hsa-ees/piconut/sw/apps/ai/cone_detection/cone_detection_data/amz_00005.jpg

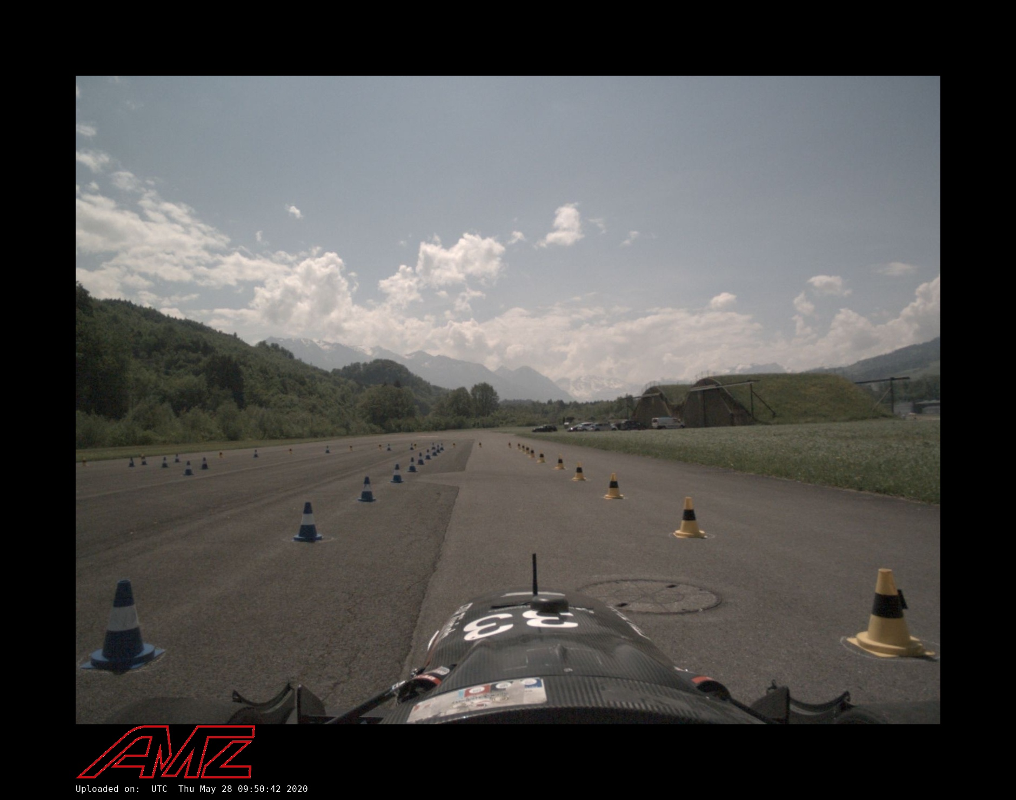
sw/apps/ai/cone_detection/cone_detection_data/amz_00005.jpg
