hsa-ees/piconut/sw/apps/ai/cone_detection/cone_detection_data/amz_01249.png

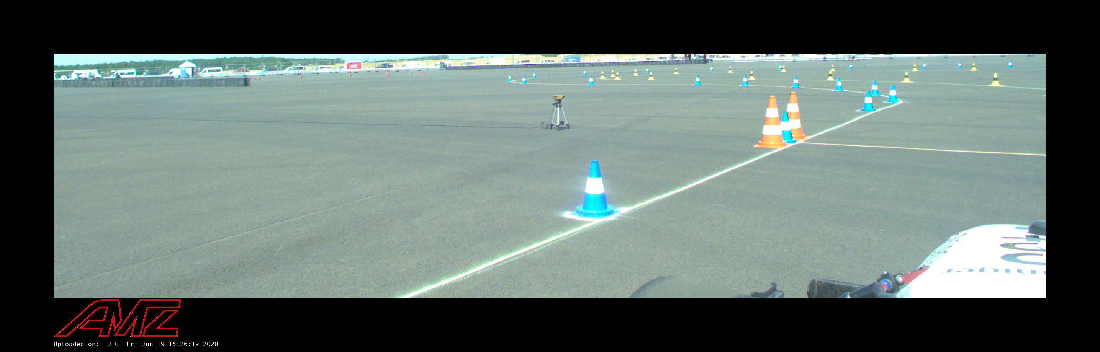
sw/apps/ai/cone_detection/cone_detection_data/amz_01249.png
