hsa-ees/piconut/sw/apps/ai/cone_detection/cone_detection_data/amz_03831.png

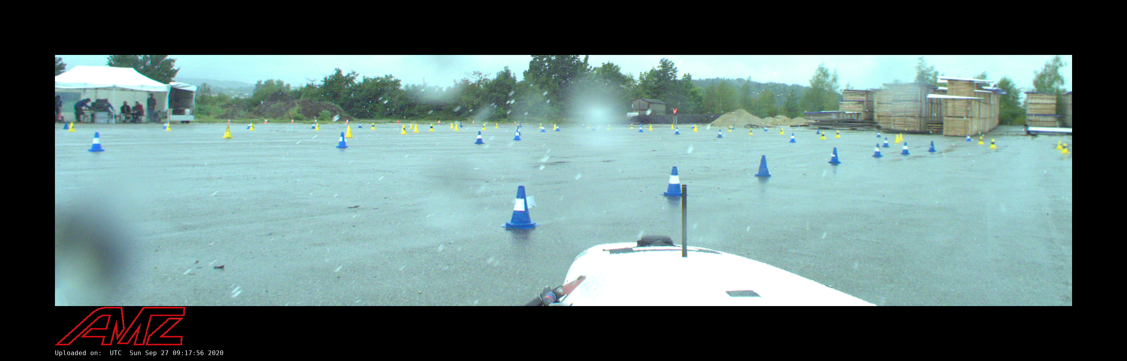
sw/apps/ai/cone_detection/cone_detection_data/amz_03831.png
