hsa-ees/piconut/doc/manual/piconut/peripherals.md

# Peripherals

```{toctree}
:maxdepth: 2

peripherals/uart.md
peripherals/video.md
peripherals/audio.md
peripherals/clint.md
peripherals/timer.md
peripherals/gui.md
peripherals/i2c.md
peripherals/gpio.md
peripherals/sdram_controller.md
```
