hsa-ees/piconut/doc/manual/piconut/software.md

# Software

The PicoNut project not only provides hardware design but also offers good
software support to help users get started quickly.

This includes software libraries geared towards PicoNut systems and RISC-V
and demonstrator applications showcasing the capabilities of PicoNut systems.

```{toctree}
:maxdepth: 2

software/demonstrators.md
software/libraries.md
```
