hsa-ees/piconut/doc/manual/piconut/interface_def.md

# Interface Definitions

```{toctree}
:maxdepth: 2

interface_def/ipdp.md
interface_def/csr_bus.md
interface_def/wishbone_bus.md
interface_def/software-sim_hardware.md
```
