hsa-ees/piconut/doc/manual/piconut/membrana.md

# Membrana Variants

```{toctree}
:maxdepth: 2

membrana/membrana_soft.md
membrana/membrana_hw.md
membrana/membrana_ref.md
```
