hsa-ees/piconut/doc/manual/piconut/nuclei.md

# Nucleus Variants

```{toctree}
:maxdepth: 2

nuclei/nucleus_ref.md
```
