hsa-ees/piconut/doc/manual/appendix/appendix.md

# Appendix

```{toctree}
:maxdepth: 2

toolchain.md
udev.md
```
