hsa-ees/piconut/doc/manual/piconut/software_library.md

# Software Support Library
**Under Construction**

```{toctree}
:maxdepth: 2

```
