hsa-ees/piconut/doc/manual/piconut/nuclei/nucleus_ref.md

# The Reference Nucleus
**Authors: Lorenz Sommer 2024, Johannes Hofmann 2025, Niklas Sirch 2025, Tristan Kundrat 2026**

```{contents} nucleus submodules
    :local:
    :depth: 2
```

This chapter gives an overview of the reference nucleus' capabilities and details its submodules.

## Overview

The main purpose of the reference nucleus is to provide a well documented and minimal implementation
of the [RV32 RISC-V ISA](https://drive.google.com/file/d/1uviu1nH-tScFfgrovvFCrj7Omv8tFtkp/view).

It is minimal in the sense that it does not contain any pipelines and does not support multi-nucleus architectures.

### Capabilities
The reference nucleus largely supports running of programs compiled by the RISC-V GCC toolchain. 
The nucleus is capable of running programs that utilize external peripherals and interrupt-driven
programming models.

It implements the following extensions of the RISC-V ISA:

- I (Base integer instruction set)
- A (Atomic instructions)
- M (Multiplication, division and remainder instructions)
- Zicsr (Control and Status Register instructions)
- Zifencei (Instruction-fetch fence instructions) - only implemented as a NOP operation as the
  reference nucleus is single core and does not reorder memory operations.

### Memory
The reference nucleus is intended for use with byte-addressable memory.
It interfaces with a so called "membrana" to access memory. It does not  access memory directly by itself.
Communication with the membrana is split into two ports, the instruction port for instruction fetching, and the data
port for `load` and `store` operations. For these ports, a [custom communication protocol](sec:idef:wishbone) has been created.
The membrana is connected to the internal system bus and acts as an interface for the nucleus' requests to the system bus.

### RISC-V Interrupt Support
The reference nucleus implements machine mode interrupt handling. The system supports the three standard machine mode interrupt types:

- **Machine External Interrupt (MEIP)** - Highest priority interrupt from external peripheral devices
- **Machine Timer Interrupt (MTIP)** - Medium priority interrupt for time-based scheduling and periodic tasks  
- **Machine Software Interrupt (MSIP)** - Lowest priority interrupt for inter-processor communication

The interrupt system includes a complete CSR (Control and Status Register) implementation with all required
machine mode registers: MIP, MIE, MSTATUS, MTVEC, MEPC, MCAUSE, and MTVAL. A hardware trap handling state machine
manages interrupt entry and exit sequences.

The nucleus integrates with CLINT (Core Local Interruptor) modules that provide memory-mapped timer and software
interrupt control at standard RISC-V addresses (base address 0x2000000).

Interrupt handling adds additional states to the controller's finite state machine, including trap entry sequences
for context saving and the MRET instruction for interrupt return. When an interrupt occurs, the hardware automatically
saves the current PC to MEPC, updates MCAUSE with the interrupt type, disables global interrupts, and transfers
control to the trap handler specified in MTVEC.

### Working principle
The reference nucleus utilizes a simple fetch-decode-execute workflow.
The `decode` step is always executed within one clock cycle. All instructions that are not `load` or `store`
instructions, also execute within one clock cycle. The `fetch` step is a IPort memory transaction and takes
3 clock cycles to complete. `load` operations require 4 clock cycles, store operations require 3.
For the time being, the ECALL and EBREAK operations halt the processor.
The FENCE operation is implemented as a NOP operation, as the nucleus does not reorder memory operations.
All Module outputs are always buffered in registers, limiting combinational logic depth and ensuring clean timing.

```{figure} figures/nucleus_ref/nucleus.drawio.svg
:align: center
reference nucleus block diagram
```

(sec:nucleus:alu)=
## Arithmetic Logic Unit (ALU)

```{figure} figures/nucleus_ref/alu.drawio.svg
:align: center
ALU module symbol
```

```{doxygenfunction} SC_MODULE(m_alu)
:project: nucleus_ref
```

### R&I-Type instructions

The ALU can handle R- and I-Type instructions. In order to correctly implement the few differences the two instruction
types have, a few distinctions have to be made. This concerns the fact, that there is no I-Type `subi` instruction.
As seen in the operation table, `funct7` decides whether subtraction is performed instead of
addition and whether to shift logically or arithmetically. According to the RISC-V
specification the only relevant values of the `funct7` block are `0x0` and `0x20` for the base RV32I instruction set
and `0x01` for the M extension. Additionally, even though I-Type instructions get decoded into their internal immediate value,
the position of the `funct7` block remains the same.

### Address calculation

Next to R- and I-Type instructions, the ALU is also indirectly used to perform address calculations for the load, store,
branch and jump instructions. It also performs the additions necessary for the LUI and AUIPC instructions. All of
the previously named instructions use the `force_add` flag to force the ALU to perform addition. Depending on the
instruction, the operands are selected accordingly by the control unit (controller). Possible sources for operand A
are `rs1` and `pc_out` (current program counter). Possible operands for operand B are `rs2` and `imm_out` (immediate value).

### Atomic Memory Operations (AMOs)

The ALU is also used to perform atomic memory operations (AMOs) from the RISC-V A-Extension.
When the controller sets the `force_amo` flag, the ALU will select the operation from
the `funct5` (contained inside `funct7`) block of the current instruction.

The 4 A-Extension specific operations `swap`, `min`, `minu`, `max` and `maxu` are implemented in
the ALU as well.

### M-/Zmmul-Extension
The M-Extension (multiplication, division and remainder instructions) are
handled by two modules: one for multiplication and one for division/remainder.

#### Multiplication and division module
Currently, multiplication is implemented as a simple shift-and-add multiplier
and division using a shift-and-subtract divider.
Calculation modules for the M-Extension can be found under `alu/m_extension/mul`
and `alu/m_extension/div` under the `nucleus_ref` folder.

Every division and multiplication module has the following structure:
```{figure} figures/nucleus_ref/mul-div-module.drawio.svg
:align: center
Multiplication/Division Module Block Diagram
```

Also, reset and clock signals are connected, if the calculation is not purely
combinatorial.

The signals have the following meaning:
| Signal name | Explanation |
| --- | --- |
| a_in | Value for calculation |
| b_in | Value for calculation |
| funct3_in | Funct3 from instruction. Contains which calculation should be made<br>(`mul`, `mulh`, `mulhu`, `mulhsu`, `div`, `divu`, `rem`, `remu`). |
| start_in | Must be set to High, when the inputs a_in and b_in are valid numbers and calculation should start.<br>Keep in mind to cache a_in and b_in in this cycle inside the multiplication/division module,<br>where start_in goes high, as after that cycle the program counter gets<br>incremented, thus the inputs can change. |
| y_out | Multiplication: {math}`a_{in} * b_{in} = y_{out}`<br>Division: {math}`a_{in} / b_{in} = y_{out}` or {math}`a_{in}\mod b_{in} = y_{out}` |
| valid_out | High, when calculation is done and the y_out signal is valid. |

##### Edge cases (for division)
Division should always round towards zero.
The following edge cases should be handled like so:
| Condition | Dividend (a) | Divisor (b) | `divu` | `remu` | `div` | `rem` |
| --- | --- | --- | --- | --- | --- | --- |
| Division by zero | {math}`x` | {math}`0` |{math}`2^{32} - 1` | {math}`x` | {math}`-1` | {math}`x` |
| Overflow (signed only) | {math}`-2^{31}` | {math}`-1` | - | - | {math}`-2^{31}` | {math}`0` |

##### Changing out the calculation modules
Signals to the multiplication and division module are connected in the `alu.cpp`
file. To change out the multiplication and/or division module with a different
version, multiple steps have to be taken. In this example, the new multiplication
module is called `mult_new` and the new division module `divi_new`.

First change the sources in the `nucleus_ref/Makefile`:
```make
# ...

# Module sources that are used for simulation and for synthesis ...
# Change the sources for the multiplication and division modules here.
MODULE_SRC := $(MODULE).cpp \
			  alu/alu.cpp \
			  alu/m_extension/mul/mult_new.cpp \
			  alu/m_extension/div/divi_new.cpp \

# ...

TESTBENCH_ALU_SRC := alu/alu.cpp \
					 alu/m_extension/mul/mult_new.cpp \
					 alu/m_extension/div/divi_new.cpp \
					 alu/alu_tb/alu_tb.cpp

# ...
```

Next, the submodules in the `nucleus_ref/alu/alu.h` header file:
```c
// ...

    /* Submodules */
#if PN_CFG_ALU_ENABLE_ZMMUL_EXTENSION == 1
    // Change class here, if you want to use a different multiplication module.
    // Also change imports accordingly.
    class m_mult_new* multiplication_module;
#endif
#if PN_CFG_ALU_ENABLE_M_EXTENSION == 1
    // Change class here, if you want to use a different division module.
    // Also change imports accordingly.
    class m_divi_new* division_module;
#endif

// ...
```

And finally, the imports and definitions in the `nucleus_ref/alu/alu.cpp` file:
```c
// ...

// change the following import to change out the multiplication module
#include "m_extension/mul/mult_new.h"
// change the following import to change out the division module
#include "m_extension/div/divi_new.h"

// ...

void m_alu::init_submodules()
{
#if PN_CFG_ALU_ENABLE_ZMMUL_EXTENSION == 1
    // change this assign according to the manual, if you want to replace
    // the multiplication module.
    multiplication_module = sc_new<m_mult_new>("mult_new");
    // ...
#endif
#if PN_CFG_ALU_ENABLE_M_EXTENSION == 1
    // change this assign according to the manual, if you want to replace
    // the division module.
    division_module = sc_new<m_divi_new>("divi_new");
    // ...
#endif
}
```

#### Enabling and disabling the M-/Zmmul-Extension
Enabling and disabling the M-/Zmmul-Extension is possible.

For enabling the entire M-Extension the variable `PN_MARCH` in the `piconut-config.mk`
has to be updated to `rv32im_zicsr` in the system using this nucleus.

Also the `PN_CFG_ALU_ENABLE_M_EXTENSION` variable in the same file has to be changed.
As an example, look at the file `piconut/systems/refdesign/piconut-config.mk`:
```make
## RISC-V ISA and extensions ...
## Changed -march argument for gcc. Comment following lines, if M and Zmmul
## extensions are not used.
# Uncomment following line, if only using Zmmul extension
# PN_MARCH ?= rv32i_zicsr_zmmul
# Uncomment following line, if using M extension
PN_MARCH ?= rv32im_zicsr

# ...

# M-Extension ...
#   Enable (1) or Disable (0) M-Extension
PN_CFG_ALU_ENABLE_M_EXTENSION ?= 1
#   Enable (1) or Disable (0) Zmmul-Extension
PN_CFG_ALU_ENABLE_ZMMUL_EXTENSION ?= 1
```

Enabling only the Zmmul-Extension, we need the following in the systems `piconut-config.mk`:
```make
## RISC-V ISA and extensions ...
## Changed -march argument for gcc. Comment following lines, if M and Zmmul
## extensions are not used.
# Uncomment following line, if only using Zmmul extension
PN_MARCH ?= rv32i_zicsr_zmmul
# Uncomment following line, if using M extension
# PN_MARCH ?= rv32im_zicsr

# ...

# M-Extension ...
#   Enable (1) or Disable (0) M-Extension
PN_CFG_ALU_ENABLE_M_EXTENSION ?= 0
#   Enable (1) or Disable (0) Zmmul-Extension
PN_CFG_ALU_ENABLE_ZMMUL_EXTENSION ?= 1
```

Disabling everything is possible via commenting the line in `piconut-config.mk` of the system
and setting both config enables to zero:
```make
## RISC-V ISA and extensions ...
## Changed -march argument for gcc. Comment following lines, if M and Zmmul
## extensions are not used.
# Uncomment following line, if only using Zmmul extension
# PN_MARCH ?= rv32i_zicsr_zmmul
# Uncomment following line, if using M extension
# PN_MARCH ?= rv32im_zicsr

# ...

# M-Extension ...
#   Enable (1) or Disable (0) M-Extension
PN_CFG_ALU_ENABLE_M_EXTENSION ?= 0
#   Enable (1) or Disable (0) Zmmul-Extension
PN_CFG_ALU_ENABLE_ZMMUL_EXTENSION ?= 0
```
Keep in mind, that the `PN_CFG_...` variables may be set by the `piconut-config.mk` in the root
directory of this project, so comment those lines out or change them accordingly.

(sec:nucleus:fpu)=
## Floating-Point Unit (FPU) &ndash; F-Extension

The reference nucleus includes a Floating-Point Unit that implements hardware-support for Floating-Point Numbers.

The module currently supports the following extensions:

- F (Single-Precision)

This module sits inside the nucleus and works alongside the ALU.

```{figure} figures/nucleus_ref/fpu.drawio.svg
:align: center
fpu / f-extension block diagram
```

```{doxygenfunction} SC_MODULE(m_f_extension)
:project: f_extension
```

### Regfile (Float)
```{doxygenfunction} SC_MODULE(m_regfile_float)
:project: f_extension
```

### Adder (Float)
```{doxygenfunction} SC_MODULE(m_adder_float)
:project: f_extension
```

### Multiplier (Float)
```{doxygenfunction} SC_MODULE(m_multiplier_float)
:project: f_extension
```

### Divisor (Float)
```{doxygenfunction} SC_MODULE(m_divisor_float)
:project: f_extension
```

### Square Root (Float)
```{doxygenfunction} SC_MODULE(m_sqrt_float)
:project: f_extension
```

### Fused Multiply-Adder (Float)
```{doxygenfunction} SC_MODULE(m_mul_add_float)
:project: f_extension
```

### Classifier (Float)
```{doxygenfunction} SC_MODULE(m_classifier_float)
:project: f_extension
```

### Comparer (Float)
```{doxygenfunction} SC_MODULE(m_compare_float)
:project: f_extension
```

### Converter (Float)
```{doxygenfunction} SC_MODULE(m_converter_float)
:project: f_extension
```

#### Enabling and disabling the F-Extension
Enabling and disabling the F-Extension is possible.

For enabling the entire F-Extension the variable `PN_MARCH` in the `piconut-config.mk`
has to be updated to `rv32if_zicsr` in the system using this nucleus.

Also the `PN_CFG_ENABLE_F_EXTENSION` variable in the same file has to be changed.
As an example, look at the file `piconut/systems/refdesign/piconut-config.mk`:
```make
## RISC-V ISA and extensions ...
# Uncomment following line, if using F extension:
# export PN_MARCH := rv32imf_zicsr

# ...

#   Enable (1) or Disable (0) F-Extension
#   Remember to also set:
#   export PN_MARCH := rv32imf_zicsr
#   for the compiler to actually use the extension
PN_CFG_ENABLE_F_EXTENSION ?= 0
```

Keep in mind, that the `PN_CFG_...` variables may be set by the `piconut-config.mk` in the root
directory of this project, so comment those lines out or change them accordingly.

(sec:nucleus:scalar_crypto)=
## Scalar Cryptography

The reference nucleus includes a scalar cryptography module that implements parts of the
[RISC-V Scalar Cryptography Extension](https://docs.riscv.org/reference/isa/unpriv/scalar-crypto.html).

The module currently supports the following extensions:

- Zkne for RV32 (NIST Encryption = AES)
- Zknd for RV32 (NIST Decryption = AES)

This module is integrated into the ALU and started when a crypto instruction is executed. Like
multiplication this module operates over multiple cycles. 

```{doxygenfunction} SC_MODULE(m_scalar_crypto)
:project: nucleus_ref
```

### AES Instructions (Zkne, Zknd)

#### Algorithm 

The Advanced Encryption Standard (AES) is the Standard for symmetric encryption specified by the
National Institute of Standards and Technology (NIST). 

AES is a round-based cipher. The number of rounds depends on the key size, and the algorithm
includes a special final round. These operations implement the core principles of symmetric-key
cryptography: confusion (making the output significantly different from the input) and diffusion
(spreading input bits across the output), combined with the addition of the round key. Decryption
applies the inverse operations in reverse order.
The basic operations displayed in the [figure below](#fig:aes_overview) of AES encryption are:

- SubBytes
  Substitution of bytes via a lookup table (S-box)
- ShiftRows
  Shifting of rows in the state matrix
- MixColumns
  Mixing of columns in the state matrix via matrix multiplication
- AddRoundKey
  XORing the state matrix with a round key

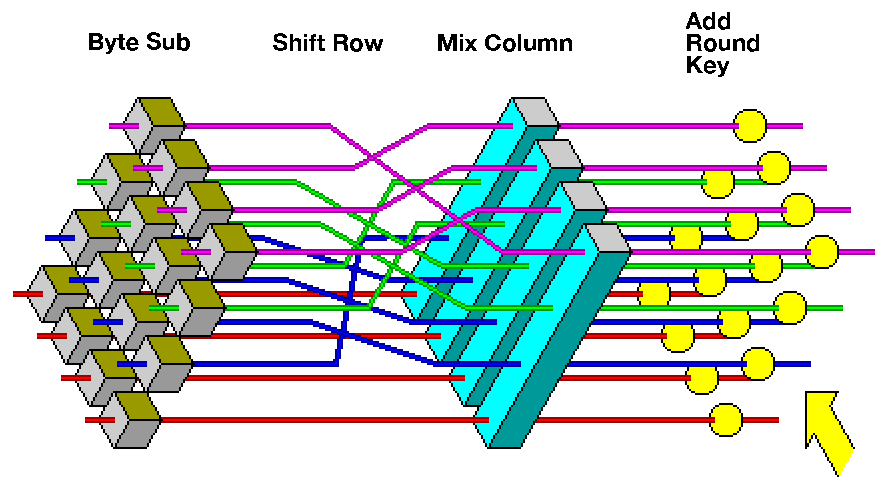
[picture p53: doc/manual/piconut/nuclei/figures/nucleus_ref/aes.png]
```{figure} figures/nucleus_ref/aes.png
:scale: 40
:align: center
:name: fig:aes_overview

AES algorithm overview (original by John Savard, CC0)
```

For the exact math please refer to
[FIPS 197](https://nvlpubs.nist.gov/nistpubs/FIPS/NIST.FIPS.197.pdf) or
[Wikipedia](https://en.wikipedia.org/wiki/Advanced_Encryption_Standard).

#### Instructions

The Zkne and Zknd extensions implement AES encryption and decryption instructions, respectively.
They are split because some cryptographic modes do not require decryption support.

There are four instructions implemented for AES encryption and decryption:

- `aes32esmi` – Middle-round AES encryption
- `aes32dsmi` – Middle-round AES decryption
- `aes32esi` – Final-round AES encryption
- `aes32dsi` – Final-round AES decryption

The instructions can be used to construct AES in software and also assist with key schedule generation.
More details can be found in the [Software Chapter](sec:sw:crypto).

The implementation of Zkne and Zknd in the reference nucleus is simple but performant for 40MHz
clock speed.

Better implementations focus on side-channel resistance, less footprint and support for faster clock
speeds but for the purpose of this reference nucleus, this implementation is sufficient.

For the exact implementation please refer to the commented source code.

(sec:nucleus:regfile)=
## Regfile

The regfile component of the nucleus is used to store temporary values that are needed for calculations
and program flow. It contains 32 32-bit registers.

```{list-table} Regfile input ports
:name: "nucleus:tab:regfile_input_ports"
:header-rows: 1

*   - Port name
    - Signal width
    - Description
*   - data_in
    - 32
    - Data input
*   - select_in
    - 5
    - Selects the register in which input data is stored
*   - rs1_select_in
    - 5
    - Selects which registers value gets output to output port `rs1_out`
*   - rs2_select_in
    - 5
    - Selects which registers value gets output to output port `rs2_out`
*   - en_load_in
    - 1
    - Control signal to enable/disable storing of input data with the next rising edge.
```

```{list-table} Regfile output ports
:name: "nucleus:tab:regfile_output_ports"
:header-rows: 1

*   - Port name
    - Signal width
    - Description
*   - rs1_out
    - 32
    - Output of the register selected by `rs1_select_in`
*   - rs2_out
    - 32
    - Output of the register selected by `rs2_select_in`
```

```{figure} figures/nucleus_ref/regfile.drawio.svg
:align: center
Regfile module symbol
```

The register `x0` holds the permanent value `0x00000000` according to the RISC-V specification.
The reset value of all registers is `0x00000000`.

(sec:nucleus:pc)=
## Program Counter (PC)

The program counter module is used to store the address of the current instruction at any given time. Its content
can be thought of as the current position within the program. The program counter is incremented by `0x4` with the next
rising edge, once the controller sets the `s_pc_inc4` control signal. Its internal value can be overwritten with the value
at its input port with the next rising edge if `s_pc_ld_en` is set. This is used to perform jump and branch instructions.

### PC Interrupt
The PC module supports RISC-V interrupt and exception handling by providing mechanisms to:
- Load trap handler addresses from the MTVEC CSR during interrupt/exception entryg
- Restore return addresses from the MEPC CSR during MRET instruction execution  

### PC Control Priority

The PC module implements a priority-based loading mechanism where interrupt/exception handling takes precedence over 
normal program flow control. The priority order (highest to lowest) is:

1. **Debug level exit** - Loads address from DPC CSR
2. **Debug level entry** - Loads debug handler start address
3. **Trap handler entry** - Loads trap handler address from MTVEC CSR
4. **Interrupt return (MRET)** - Loads return address from MEPC CSR
5. **Normal load** - Loads address from `pc_in` (jump/branch instructions)
6. **Increment** - Increments PC by 4 (normal instruction sequence)

```{list-table} Program counter input ports
:name: "nucleus:tab:pc_input_ports"
:header-rows: 1

*   - Port name
    - Signal width
    - Description
*   - pc_in
    - 32
    - Data input for when the PC is to be manipulated by jump and branch instructions.
*   - inc_in
    - 1
    - Control signal. When set, the PC is incremented by `0x4` at the next rising edge.
*   - en_load_in
    - 1
    - Control signal. Enables loading of a new value with the next rising edge.
*   - debug_level_enter_in
    - 1
    - Debug level entry signal. Loads debug handler start address.
*   - debug_level_leave_in
    - 1
    - Debug level exit signal. Loads address from DPC CSR.
*   - csr_dpc_in
    - 32
    - Debug Program Counter from CSR module.
*   - trap_handler_enter_in
    - 1
    - Trap handler entry signal for interrupt/exception handling.
*   - csr_mtvec_in
    - 32
    - Machine Trap Vector from CSR module containing trap handler base address.
*   - mret_in
    - 1
    - Machine Return instruction signal for interrupt/exception return.
*   - csr_mepc_in
    - 32
    - Machine Exception Program Counter from CSR module containing return address.
```

```{note} Program counter internal register
The internal register of the program counter is **30 bits wide**. The lowest two bits of any given address pertaining
to the main program in memory can be omitted because every instruction is naturally word aligned and 4 bytes in size.
To maintain a level of consistency for the program counters interactions with other modules and the instruction port
interface, the output and input ports kept at a width of 32 bits. The lowest two bits are simply set to a constant `0` at the output and dismissed at the input. Instead of
every connected module having to append these two zeroes at their inputs, it is done once at the PCs output. The same goes for the PC input port.
```

### Interrupt and Exception Handling

The PC module plays a critical role in RISC-V interrupt and exception handling:

**Trap Entry**: When an interrupt or exception occurs, the controller asserts `trap_handler_enter_in`, causing the PC 
to load the trap handler address from the MTVEC CSR. This automatically transfers control to the interrupt service routine.

**Trap Exit**: The MRET (Machine Return) instruction asserts `mret_in`, causing the PC to load the return address 
from the MEPC CSR, restoring execution to the point where the interrupt occurred.

**Priority Handling**: The PC module ensures that interrupt/exception control takes precedence over normal program 
flow, preventing race conditions during trap handling sequences.

```{list-table} Program counter output ports
:name: "nucleus:tab:pc_output_ports"
:header-rows: 1

*   - Port name
    - Signal width
    - Description
*   - pc_out
    - 32
    - Constant output of the internal register.
```

```{figure} figures/nucleus_ref/pc.drawio.svg
:align: center
Program counter module symbol
```

(sec:nucleus:ir)=
## Instruction Register (IR)

The instruction register module stores the current instruction in its internal register and provides its content
to the rest of the nucleus via a constant output.

```{list-table} Instruction register input ports
:name: "nucleus:tab:ir_input_ports"
:header-rows: 1

*   - Port name
    - Signal width
    - Description
*   - ir_in
    - 32
    - Input data. Internal register takes on this value at the next rising edge.
*   - en_load_in
    - 1
    - Control signal. Enables loading of a new value with the next rising edge.
```

```{list-table} Instruction register output ports
:name: "nucleus:tab:ir_output_ports"
:header-rows: 1

*   - Port name
    - Signal width
    - Description
*   - ir_out
    - 32
    - Constant output of the internal register.
```

The IR input port `data_in` is connected to the IPort `rdata` signal.

```{figure} figures/nucleus_ref/ir.drawio.svg
:align: center
Instruction register module symbol
```

(sec:nucleus:immgen)=
## Immediate Generator (immgen)

The immediate generator (immgen) module decodes the current instruction and generates an immediate value from it.
All but the R-Type instruction type carry an immediate value. This immediate value is a simple constant built into
an instruction.

```{list-table} Immediate generator input ports
:name: "nucleus:tab:immgen_input_ports"
:header-rows: 1

*   - Port name
    - Signal width
    - Description
*   - data_in
    - 32
    - Instruction word from which an immediate value is to be generated from.
```

```{list-table} Immediate generator output ports
:name: "nucleus:tab:immgen_output_ports"
:header-rows: 1

*   - Port name
    - Signal width
    - Description
*   - imm_out
    - 32
    - Immediate value generated from an instruction word.
```

Immediate values are decoded differently and serve a different purpose depending on the instruction and instruction type.
Decoding and generation are executed in accordance with the [RISC-V specification](https://drive.google.com/file/d/1uviu1nH-tScFfgrovvFCrj7Omv8tFtkp/edit)
page 44, section "Immediate Encoding Variants.

```{list-table} Immediate encoding variants
:name: "nucleus:tab:immgen_decoding"
:header-rows: 1

*   - Instruction Type
    - Resulting immediate value
*   - I-Type
    - `(inst[31])[31:11] + inst[30:25] + inst[24:21] + inst[20]`
*   - S-Type
    - `(inst[31])[31:11] + inst[30:25] + inst[11:8]  + inst[7]`
*   - B-Type
    - `(inst[31])[31:12] + inst[7]     + inst[30:25] + inst[11:8]  + 0`
*   - U-Type
    - `inst[31]          + inst[30:20] + inst[19:12] + 0[11:0]`
*   - J-Type
    - `(inst[31])[31:20] + inst[19:12] + inst[20]    + inst[30:25] + inst[24:21] + 0`

```

```{admonition} How to read the immediate encoding table
:class: tip

In the table above, `inst` stands for the current instruction word from which an immediate value is to be generated from.
The operator `+` in this case stands for concatenation of bits/bit-ranges.
Additionally, syntax like `(inst[31])[31:12]` resolves as: "fill the range `[31:12]` in the output value with `inst[31]`".
```

The immediate generator module detects the correct decoding variant by evaluating the `opcode` field of the current
instruction. Groups of instructions in the RV32I subset (load/store/immediate/branch/jump/upper immediate) do not
always use the same instruction type format across the board.

```{list-table} Instructions by instruction type
:name: "nucleus:tab:instruction_type_per_instruction"
:header-rows: 1

*   - Instruction type
    - Instructions
*   - I-Type
    - All "immediate arithmetic" instructions, all `load` instructions, **`jalr`**
*   - S-Type
    - All `store` instructions
*   - B-Type
    - All `branch` instructions
*   - U-Type
    - `lui`, `auipc`
*   - J-Type
    - `jal`
```

```{note}
The R-Type instruction format is not listed, since it does not contain an immediate value.
```

```{figure} figures/nucleus_ref/immgen.drawio.svg
:align: center
Immediate generator module symbol
```

(sec:nucleus:byteselector)=
## Byteselector

The byteselector module generates the `bsel` signal. This signal is forwarded to the data port interface as
well as modules that handle memory access. It is necessary for the implementation of byte and halfword load/
store commands.

```{list-table} Byteselector input ports
:name: "nucleus:tab:bsel_input_ports"
:header-rows: 1

*   - Port name
    - Signal width
    - Description
*   - adr_in
    - 2
    - Lowest two bits of the `alu_out` signal which represents the alignment of a calculated address.
*   - funct3_in
    - 3
    - `funct3` block of the current instruction.
```

```{list-table} Byteselector output ports
:name: "nucleus:tab:bsel_output_ports"
:header-rows: 1

*   - Port name
    - Signal width
    - Description
*   - byteselect_out
    - 4
    - Outgoing byteselect signal.
*   - invalid_out
    - 1
    - Set if adress is misaligned.

```

Because memory accesses always use a full 32-bit word aligned address (lowest two bits are `0`) it is necessary to
generate an additional signal to allow for loading/storing of individual bytes and halfwords. This `bsel` signal
signifies which of the 4 bytes of a 32-bit word at a given address are to be loaded from or stored to. The `bsel` signal
is 4 bits wide and each bit represents a single byte of a 32-bit word.

When an address is calculated by the ALU, only the upper 30 bits are forwarded to the data port interface.
Memory accesses must always be word aligned and thus the lowest two bits of any address must always be `00`.
This is because the main memory is byte-addressable and therefore 32-bit words sit in memory in intervals of `0x4`,
leading to the lowest to bits always being `00`.For the purpose of generating the `bsel` signal, they - along with the
`funct3`  block of the current  instruction - lead to the following `bsel` signal assignments.

```{list-table} Byteselect generation table
:name: "nucleus:tab:bsel_generation_table"
:header-rows: 1

*   - adr_in
    - funct3_in
    - bsel_out
*   - `00`
    - lb/lbu/sb
    - `0001`
*   - `01`
    - lb/lbu/sb
    - `0010`
*   - `10`
    - lb/lbu/sb
    - `0100`
*   - `11`
    - lb/lbu/sb
    - `1000`
*   - `00`
    - lh/lhu/sh
    - `0011`
*   - `10`
    - lh/lhu/sh
    - `1100`
*   - `01`
    - lh/lhu/sh
    - invalid, `invalid_out` is set
*   - `11`
    - lh/lhu/sh
    - invalid, `invalid_out` is set
*   - `00`
    - lw
    - `1111`
*   - `01`
    - lw
    - invalid, `invalid_out` is set
*   - `10`
    - lw
    - invalid, `invalid_out` is set
*   - `11`
    - lw
    - invalid, `invalid_out` is set
```

```{note}
The nucleus currently only supports fully 32-bit aligned loads and stores. It is not possible to load/store data
beyond the 32-bit boundary of any address. Additionally, disjointed loads are also not supported. (for example `bsel` `0101`).
```
### Examples

To further illustrate the interaction between the effective address and the `bsel` signal, consider the following examples:

Assume the following memory layout.

| Address | Value |
| --- | --- |
| `0x00000000` | `0x12 0x34 0x56 0x78` |
| `0x00000004` | `0xCA 0xFE 0xBA 0xBE` |

#### Example 1

1. Let the registers `x1` and `x2` contain the value `0`.
2. Let the current instruction be `lb x1, 1(x2)`.
3. This reads as "load the value of the byte at address `0x00000000` offset by `0x1` into `x1`.
4. This leads to an effective target address of `0x00000001`.
5. The targeted byte is therefore `0x34`.
6. The address at the dport interface wil be `0x00000000`. (Lowest two bits always `00`!)
7. The byteselector will evaluate the `funct3` block (here: `0x0`) and the lowest two bits of the effective address
   (here: `0x1`), resulting in a `bsel` value of `0010`.
8. After the memory access transaction is complete, the register `x1` will contain the value `0x00000034`.

#### Example 2

1. Let the register `x1` contain the value `0x0` and register `x2` contain the value `0x00000004`.
2. Let the current instruction be `lh x1, 2(x2)`.
3. This reads as "load the value of the halfword at address `0x00000004` offset by `0x2` into `x1`.
4. This leads to an effective address of `0x00000006`.
5. The targeted halfword is therefore `0xBABE`.
6. The address at the dport interface wil be `0x00000004`. (Lowest two bits always `00`!)
7. The byteselector will evaluate the `funct3` block (here: `0x1`) and the lowest two bits of the effective address
   (here: `0x2`), resulting in a `bsel` value of `1100`.
8. After the memory transaction is complete. the register `x1` will contain the value `0x0000BABE`.

```{note}
The examples above only demonstrate the generation and function of the `bsel` signal. A full memory transaction involves
additional modules.
```

```{figure} figures/nucleus_ref/byteselector.drawio.svg
:align: center

Byteselector module symbol
```

(sec:nucleus:extender)=
## Extender

The extender module prepares **incoming** data requested by the nucleus via load instructions. It ensures
relevant data is in the correct position within the data word and sign extends it, if needed.

```{list-table} Extender input ports
:name: "nucleus:tab:extender_input_ports"
:header-rows: 1

*   - Port name
    - Signal width
    - Description
*   - data_in
    - 32
    - Incoming data word to be processed
*   - funct3_in
    - 3
    - funct3 block of the current instruction
*   - bsel_in
    - 4
    - Byteselect signal generated by the byteselector.
```

```{list-table} Extender output ports
:name: "nucleus:tab:extender_output_ports"
:header-rows: 1

*   - Port name
    - Signal width
    - Description
*   - extend_out
    - 32
    - Processed data word
```

When the nucleus requests data from memory via a load instruction, the membrana will always provide a 32-bit
data word. If the load instruction requests a full 32-bit word (lw instruction) no further steps have to be taken and
the full data word is stored in the target internal register. This changes, when the nucleus requests to load
a byte or halfword via the lb or lh instructions respectively. The membrana will still provide a 32-bit word
with the relevant data occupying either any of the single 4 bytes within the full word (lb) or two consecutive bytes
(lh). The purpose of this module is to resolve this arrangement and to reorient it to form a new 32-bit word
that represents this data. For this, the extender module uses the `bsel` signal already provided by the
[Byteselector](sec:nucleus:byteselector) buffered through the `bsel` register. The `bsel` signal represents a
mask where each of its bits corresponds to a byte in the incoming data word.

```{list-table} Extender output table
:name: "nucleus:tab:extender_table"
:header-rows: 1

*   - Incoming data
    - `bsel`
    - Output
*   - `0x12345678`
    - `0001`
    - `0x00000078`
*   - `0x12345678`
    - `0010`
    - `0x00000056`
*   - `0x12345678`
    - `0100`
    - `0x00000034`
*   - `0x12345678`
    - `1000`
    - `0x00000012`
*   - `0x12345678`
    - `0011`
    - `0x00005678`
*   - `0x12345678`
    - `1100`
    - `0x00001234`
```

In addition to rearranging the relevant bytes or halfwords, the extender module
is responsible for applying the correct extension to the loaded data. For `lb`
and `lh` instructions, sign extension is performed: the module inspects the most
significant bit of the selected byte or halfword and, if it is set, fills the
upper bits of the output word with ones. For `lbu` and `lhu` instructions, zero
extension is applied, ensuring the upper bits are cleared. This behavior is
determined by evaluating the `funct3` field of the current instruction.

For A-Extension instructions, write-backs from the `rdata` register require the extender module to
use the `bsel` value stored in the `bsel` register, which holds the `bsel` from the most recent load
instruction. This is necessary because, during A-Extension operations, the address is not calculated
by the ALU, so the current `bsel` would not reflect the correct byte selection. 

```{figure} figures/nucleus_ref/extender.drawio.svg
:align: center
Extender module symbol
```

(sec:nucleus:datahandler)=
## Datahandler

The datahandler module is prepares **outgoing** data to the Dport interface. It ensures data within the outgoing 32-bit
word is in the correct position.

```{list-table} Datahandler input ports
:name: "nucleus:tab:datahandler_input_ports"
:header-rows: 1

*   - Port name
    - Signal width
    - Description
*   - data_in
    - 32
    - Incoming data word to be processed
*   - bsel_in
    - 4
    - Byteselect signal generated by the byteselector
```

```{list-table} Datahandler output ports
:name: "nucleus:tab:datahandler_output_ports"
:header-rows: 1

*   - Port name
    - Signal width
    - Description
*   - data_out
    - 32
    - Processed data word
```

Data stored in any internal register (the regfile) occupies the low bits of the register according to the RISC-V
specification. However, since `sb` and `sh` instructions enable the storing of individual bytes and halfwords to a
specific, byte or halfword aligned position within any given memory address, it is necessary to rearrange outgoing
data accordingly. Essentially, the datahandler module performs the inverse operation of the
[extender module](sec:nucleus:extender). It uses the `bsel` signal to determine which position within the outgoing
data word the incoming data should occupy. Unlike the [extender module](sec:nucleus:extender), it does not perform
any sign or zero extension.

```{list-table} Datahandler output table
:name: "nucleus:tab:datahandler_table"
:header-rows: 1

*   - Incoming data
    - `bsel`
    - Output
*   - `0x00000012`
    - `1000`
    - `0x12000000`
*   - `0x00000012`
    - `0100`
    - `0x00120000`
*   - `0x00000012`
    - `0010`
    - `0x00001200`
*   - `0x00000012`
    - `0001`
    - `0x00000012`
*   - `0x00001234`
    - `1100`
    - `0x12340000`
*   - `0x00001234`
    - `0011`
    - `0x00001234`
*   - `0x12345678`
    - `1111`
    - `0x12345678`
```

```{figure} figures/nucleus_ref/datahandler.drawio.svg
:align: center
Datahandler module symbol
```

(sec:nucleus:controller)=
## Controller

The controller (also known as the control unit) is a finite state machine that sets a number of control signals which control
signal flow and toggle functions of other submodules. It reads status signals from various parts of the nucleus and evaluates
them at specific decision points to facilitate the overall function of executing instructions by setting control signals accordingly.
The controller also implements interrupt and trap handling, managing the multi-state sequences required for
interrupt entry, context saving, and interrupt return (MRET) operations.

```{doxygenfunction} SC_MODULE(m_controller)
:project: nucleus_ref
```
The controller operates as a finite state machine with 53 distinct internal states, transitioning
between them based on current status signals and instruction flow.

The diagram below provides an overview of the controller's state machine and its transitions.

```{figure} figures/nucleus_ref/controller.drawio.svg
:align: center
Controller state machine diagram
```

```{list-table} Controller logical states
:name: "nucleus:tab:controller_states"
:header-rows: 1

*   - State name
    - Description
*   - `RESET`
    - Initial state. Resets all control signals.
*   - `IPORT_STB`
    - Instruction port strobe is set high.
*   - `AWAIT_IPORT_ACK`
    - Await the instruction port acknowledge signal.
*   - `DECODE`
    - Instruction fetched. Decode the current instruction.
*   - `ALU1`
    - Execute ALU instructions, PC advances by `0x4`.
*   - `ALU2`
    - Execute ALU instructions, PC does not change.
*   - `ALU_IMM`
    - Execute immediate ALU operations (I-Type).
*   - `ALU_IMM_SHIFT`
    - Execute immediate ALU shift instructions.
*   - `LUI`
    - Execute upper immediate instructions.
*   - `AUIPC`
    - Execute add upper immediate to PC instructions.
*   - `NOP`
    - No operation, PC advances by `0x4`.
*   - `BRANCH`
    - Calculate branch target address and set PC if condition is met.
*  - `DONT_BRANCH`
    - Do not branch, PC advances by `0x4`.
*   - `JAL`
    - Jump and link instruction. Calculate address and set PC.
*   - `JALR`
    - Jump and link register instruction. Calculate address and set PC.
```

### Load and Store

The load and store procedures (and related states) are subject to optimization and currently focus on on eliminating
potential edge cases to ensure proper function.

```{list-table} Controller load/store states
:name: "nucleus:tab:controller_load_store_states"
:header-rows: 1

*   - State name
    - Description
*   - `LOAD1`
    - Await data port acknowledge signal is low to ensure no conflict with an ongoing transaction. Then go to `LOAD2` else remain.
*   - `LOAD2`
    - Set data port strobe signal high to begin transaction. Calculate the target address and increment PC. Go to `LOAD3`.
*   - `LOAD3`
    - Await data port acknowledge signal. If high, go to `LOAD4`, else remain.
*   - `LOAD4`
    - Data port acknowledge signal is high. Enable regfile to load data and go to `IPORT_STB`.
*   -
    -
*   - `STORE1`
    - Await data port acknowledge signal is low to ensure no conflict with an ongoing transaction. Then go to `STORE2` else remain.
*   - `STORE2`
    - Set data port strobe signal high to begin transaction. Calculate the target address and increment PC. Set write enable signal high. Go to `STORE3`.
*   - `STORE3`
    - Await data port acknowledge signal. If high, go to `IPORT_STB`, else remain.
```

The interrupt and trap handling procedures extend the controller with additional states for interrupt processing and CSR instruction execution.

```{list-table} Controller interrupt and trap states
:name: "nucleus:tab:controller_interrupt_states"
:header-rows: 1

*   - State name
    - Description
*   - `STATE_TRAP_ENTRY`
    - Initial trap detection. Save current PC to MEPC register.
*   - `STATE_TRAP_SAVE_MCAUSE`
    - Determine interrupt type by priority and save to MCAUSE register with interrupt flag set.
*   - `STATE_TRAP_UPDATE_MSTATUS`
    - Read current MSTATUS register to preserve state.
*   - `STATE_TRAP_UPDATE_MSTATUS2`
    - Save current MIE bit to MPIE field and clear MIE bit to disable global interrupts.
*   - `STATE_TRAP_LOAD_HANDLER`
    - Read trap handler base address from MTVEC register.
*   - `STATE_TRAP_SAVE_PC`
    - Transfer control to interrupt handler by loading trap handler address into PC.
*   - `STATE_MRET`
    - Execute machine return (MRET) instruction: restore MIE from MPIE, load PC from MEPC.
```
```{note}
The controller checks for a pending interrupt condition in several states: during the instruction_finished() routine as well as in the IPORT_STB and AWAIT_IPORT_ACK states. If an interrupt is pending in any of these, the state machine immediately transitions to STATE_TRAP_ENTRY to initiate the trap handling sequence.
```
```{note}
While load and store procedures are essentially the same, the load procedure required an additional state to
avoid erroneous behavior when the target and source register (that holds the target address) are the same.
The specific solution was to delay the  signals that allow the regfile to load a new value (`c_reg_ldmem`, `c_reg_ld_en`)
and enable them only after the bus transaction is complete and when the data present at the regfile input signal is valid.

There is potential for skipping over states when certain conditions are met, this however has not
 been explored with this implementation and is subject to future optimization.
```

### Branching

Because the `BRANCH` and `DONT_BRANCH` transition edges would clutter the diagram unnecessarily, their conditions
are detailed in the following table

```{note}
The table is meant to be read such that if the conditions in the "Conditions" column are met, the controller transitions
into the `BRANCH` state, else it transitions into the `DONT_BRANCH` state.
```

```{list-table} Branch conditions
:name: "nucleus:tab:branch_conditions"
:header-rows: 1

*   - Branch Type and opcode
    - Condition
*   - `BEQ`, `0x0`
    - `s_alu_equal == 1`
*   - `BNE`, `0x1`
    - `s_alu_equal == 0`
*   - `BLT`, `0x4`
    - `s_alu_less == 1`
*   - `BGE`, `0x5`
    - `s_alu_less == 0`
*   - `BLTU`, `0x6`
    - `s_alu_lessu == 1`
*   - `BGEU`, `0x7`
    - `s_alu_lessu == 0`
```

### A-Extension

The A-Extension (atomic instructions) is handled by a dedicated set of
controller states. These states coordinate the execution of atomic memory
operations (AMOs), as well as load-reserved (LR) and store-conditional (SC)
instructions.

Even though the reference nucleus does not support multi-core systems, the A-Extension
is implemented to allow for future expansion.

For AMOs in general, the controller first performs a load from memory, then
executes the specified atomic operation in the ALU, and finally writes the
result back to memory. To ensure that all possible register combinations are
supported Piconut has to keep the old value in the rdata register before writing
it to the rd register.  To support multicore systems in the future a `dport_amo`
flag is set to indicate that the current transaction is an AMO. A membrana module
has to garantee that during that time no other core can access the same memory
address.

For LR/SC instructions, the controller indicates by the `dport_lrsc` signal that
a load-reserved or store-conditional operation is being performed. On the
store-conditional operation the membrana has to return '0' over rdata if the
load-reserved operation was successful, or '1' if it was not. The controller
then writes the result of the store-conditional operation to the rd register.

```{note} LR/SC Eventual Success
Section 13.3. of unprivileged RISC-V ISA specification (20250508) explains under which conditions a store-conditional
operation is successful.

Two notes on this:
1. The PicoNut does not enforce the limit of 16 instructions between the LR and SC instructions as this is not mandatory
   but only a optimization for caching.
2. Aligning with the spec interupts do not invalidate reservations. But note that software can invalidate the
   reservations in preemptive context switch by doing a store-conditional on a dummy location as described
   [here](https://stackoverflow.com/questions/59605870/about-lr-sc-in-two-soft-threads-on-same-hart)
```

The following table describes each state and its function:

```{list-table} Controller A-Extension states
:name: "nucleus:tab:controller_a_extension_states"
:header-rows: 1

*   - State name
    - Description
*   - `LR1`
    - Awaits data port acknowledge signal is low, ensuring no ongoing transaction. Proceeds to `LR2` when ready.
*   - `LR2`
    - Initiates a LOAD transaction by setting the data port strobe signal high and asserts `dport_lrsc` to indicate a load-reserved operation. Advances to `LR3`.
*   - `LR3`
    - Awaits data port acknowledge signal. Upon acknowledgment, transitions to `LOAD_RDATA`. The loaded data is available in the rdata register and will be written to the `rd` register.
*   - `SC1`
    - Awaits data port acknowledge signal is low. Proceeds to `SC2` when ready.
*   - `SC2`
    - Initiates a STORE transaction by setting the data port strobe signal high and asserts `dport_lrsc` to indicate a store-conditional operation. Advances to `SC3`.
*   - `SC3`
    - Awaits data port acknowledge signal. Upon acknowledgment, transitions to `LOAD_RDATA`. The result of the store-conditional operation is received via the rdata register and stored in the `rd` register.
*   - `AMO_LOAD1`
    - Awaits data port acknowledge signal is low. Proceeds to `AMO_LOAD2` when ready.
*   - `AMO_LOAD2`
    - Initiates an AMO LOAD transaction by setting the data port strobe signal high. Advances to `AMO_LOAD3`.
*   - `AMO_LOAD3`
    - Awaits data port acknowledge signal. Upon acknowledgment, transitions to `AMO_OP`. The loaded data is held in the rdata register for the AMO operation, without overwriting any register.
*   - `AMO_OP`
    - Executes the AMO operation in the ALU. The result is written directly to the wdata register. Proceeds to `AMO_STORE1`.
*   - `AMO_STORE1`
    - Awaits data port acknowledge signal is low. Proceeds to `AMO_STORE2` when ready.
*   - `AMO_STORE2`
    - Initiates an AMO STORE transaction by setting the data port strobe signal high. Advances to `AMO_STORE3`.
*   - `AMO_STORE3`
    - Awaits data port acknowledge signal. Upon acknowledgment, transitions to `LOAD_RDATA`. The previous value of `*rs1` is written to the `rd` register.
*   - `LOAD_RDATA`
    - Shared state for all A-Extension instructions. Loads the prestored data (AMO) or loaded (LR) or status (SC) from the rdata register into the `rd` register and increments the PC by `0x4`. This completes the instruction.
```

## CSR Master

```{figure} figures/nucleus_ref/csr-master.drawio.svg
:align: center
CSR-Master module symbol
```

```{doxygenfunction} SC_MODULE(m_csr_master)
:project: nucleus_ref
```

## CSR

```{figure} figures/nucleus_ref/csr.drawio.svg
:align: center
CSR module symbol
```

```{doxygenfunction} SC_MODULE(m_csr)
:project: nucleus_ref
```
