hsa-ees/piconut/doc/manual/piconut/membrana/membrana_hw.md

# Membrana Hardware Version

**Author: Claus Janicher 2025**

The membrana_hw module is the main interface between the Nucleus and the Systembus. As Systembus this project uses Wishbone which is a well documented bus.

This module has a state-machine which performs the necessary tasks the processor is asking for. The program is in the current state stored in the built in Blockram module. This module is being created with the membrana_hw and only accessible via the IPort and DPort interface from the processor.

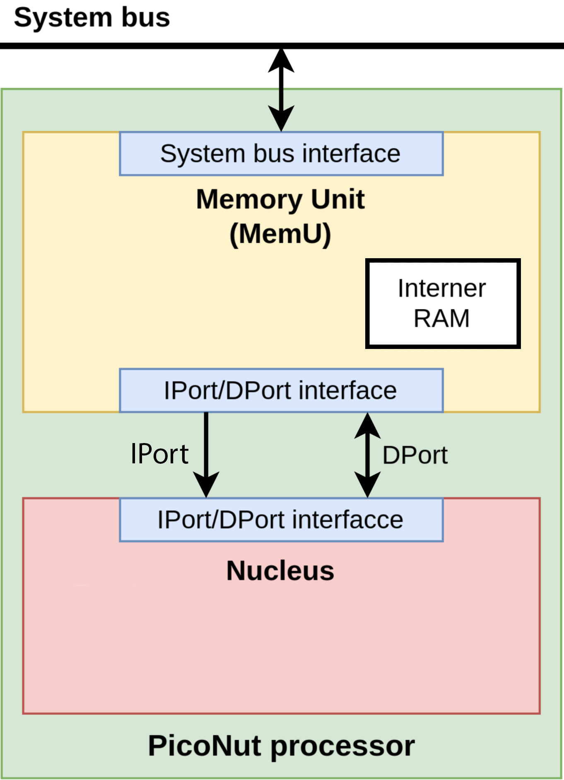
[picture p55: doc/manual/piconut/membrana/figures/membrana_hw/memu_core_perfect.png]
```{figure} ./figures/membrana_hw/memu_core_perfect.png
:name: membrana_hw_currently
:width: 75%
:align: center
Diagram of the current implemented Hardware Membrana.
```

```{doxygenfunction} SC_MODULE(m_membrana_hw)
:project: membrana_hw
```

## Integrated Blockram

```{doxygenfunction} SC_MODULE(m_membrana_hw_emem)
:project: membrana_hw
```

## Interfaces

The main interface connections from the Membrana to the Nucleus processor are the {ref}`sec:idef:ipdp` bus systems.
The other side of the Membrana is connected to the {ref}`sec:idef:wishbone`, on which the membrana communicates as a Master.

## config-parameters in hw/piconut/config.mk

The BRAM size defines the size the internal blockram module has, which is being used for simulation
and hardware synthesis. The START_ADDRESS is being used as a address subtraction method for the
blockram, which doesn't use the offset because its addresses start at 0x00000000.

- CFG_START_ADDRESS = 0x10000000
- CFG_MEMBRANA_BRAM_SIZE = 102399
