hsa-ees/piconut/doc/manual/piconut/membrana/membrana_soft.md

# Membrana Software Version
**Under Construction**
