hsa-ees/piconut/doc/manual/piconut/peripherals/audio.md

# Audio

```{toctree}
:maxdepth: 2

audio/c_soft_audio.md
audio/audio.md
```
