hsa-ees/piconut/doc/manual/piconut/peripherals/audio/c_soft_audio.md

# Audio Interface
**Under Construction**
