hsa-ees/piconut/doc/manual/piconut/debugging.md

# Debugging
**Author: Johannes Hofmann 2025**

For developing larger and more complex software, a debugger is an essential tool.
It allows developers to analyze and control program execution with features such as:
 - Starting and stopping execution
 - Setting breakpoints
 - Reading and writing memory
 - Reading and writing registers

One widely used debugger is the `GNU Debugger (GDB)`. When debugging embedded
hardware, `OpenOCD` is required to facilitate communication between the hardware
and GDB.

The debug hardware follows the `RISC-V External Debug Support` specification, ensuring compatibility with GDB for seamless debugging.

In figure Overview of the debug hardware you can see the debug infrastructure
architecture.

```{figure} ./figures/debugger/Overview.drawio.svg
:name: debugger_overview
:width: 100%
:align: center
Overview of the debug hardware
```

## Soft Debugger

### Remote BitBang

```{doxygengroup} c_remote_bitbang
:project: remote_bitbang
```

#### Functions

```{doxygenfunction} c_remote_bitbang
:project: remote_bitbang
```

```{doxygenfunction} ~c_remote_bitbang
:project: remote_bitbang
```

```{doxygenfunction} process
:project: remote_bitbang
```

```{doxygenfunction} connected
:project: remote_bitbang
```

### Debug Module Interface (DMI)

The `DMI` is the interface between the `Debug Transport Module (DTM)` and the
`Debug Module (DM)`. For the software debugger its three functions that the `DM` (DMI slave)
has to implement which are called by the `DTM` (DMI master):
- `void dmi_write(uint8_t adr, uint32_t data)`: Called when a register write operation is performed.
- `uint32_t dmi_read(uint8_t data)`: Called when a register read operation is performed.
- `void dmi_reset()`: Called when a reset operation is performed.

### Debug Transport Module (DTM)

```{figure} ./figures/debugger/jtag_tap_controller_state_diagram.svg
:name: debugger_dtm_tap
:width: 100%
:align: center
Overview TAP-Machine.
```

```{doxygengroup} c_dtm
:project: debugger_soft
```

#### Functions

```{doxygenfunction} c_dtm
:project: debugger_soft
```

```{doxygenfunction} ~c_dtm
:project: debugger_soft
```

```{doxygenfunction} jtag_set_input_pins
:project: debugger_soft
```

```{doxygenfunction} jtag_get_output_pin
:project: debugger_soft
```

```{doxygenfunction} get_instruction_reg_width
:project: debugger_soft
```

```{doxygenfunction} get_data_reg_width
:project: debugger_soft
```

### Debug Module (DM)

```{doxygengroup} c_soft_dm
:project: debugger_soft
```

#### Debug registers

```{doxygengroup} c_debug_regs
:project: debugger_soft
```

```{doxygengroup} c_debug_reg_command
:project: debugger_soft
```

```{doxygengroup} c_debug_reg_abstractcs
:project: debugger_soft
```

#### Functions

```{doxygenfunction} c_soft_dm
:project: debugger_soft
```

```{doxygenfunction} ~c_soft_dm
:project: debugger_soft
```

```{doxygenfunction} get_info
:project: debugger_soft
```

```{doxygenfunction} is_addressed
:project: debugger_soft
```

```{doxygenfunction} read32
:project: debugger_soft
```

```{doxygenfunction} write32
:project: debugger_soft
```

```{doxygenfunction} dmi_write
:project: debugger_soft
```

```{doxygenfunction} dmi_read
:project: debugger_soft
```

```{doxygenfunction} dmi_reset
:project: debugger_soft
```

### Soft Debugger Wrapper

This module serves as a wrapper for all debugger_soft modules.
It instantiates a `remote_bitbang`, a `c_dtm` and a `c_soft_dm`.
The `c_soft_peripheral` interface is forwarded to the `c_soft_dm`.

Note: The module is not synthesizable and is only used for simulation purposes.

## Debug Handler

The debug handler is a routine executed by the processor when entering debug mode.
Its purpose is to process commands received from the host system and resume
the main program if requested. Written in RISC-V assembly, it operates in
four stages: `_entry`, `_loop`, `_run_cmd`, and `_resume`. Execution begins
at `_entry`, then moves to `_loop,` where it waits for a `resume request` or a
`run command request`. If either is set, the handler jumps to the corresponding
stage. The `_run_cmd` stage concludes by setting the program counter to the
first `abstract command` register of the `DM`.
According to the External Debug Support standard, the last command from the
host, whether an `abstract command` or `progbuf` is an `EBREAK` instruction.
As a result, the debug handler is executed again after the last command.

```{note}
Currently there is no exception handling implemented. The debug handler
needs to be extended when the piconut supports exception handling.
```

The `Debug Handler` program behaves like described in the diagram below.

```{figure} ./figures/debugger/debug_handler_flow_diagram.drawio.svg
:name: debug_handler_flow_diagram
:width: 30%
:align: center
Debug Handler program flow.
```

## Hardware Debugger

**Under construction**

## Usage

For the soft debugger an example system can be found at `systems/demo_debugger_soft`.
For the synthesizeable debugger an example system can be found at `systems/demo_debugger`.

1. Execute a system that instantiates a debugger. For example the demo_debugger_soft

```console
$ cd systems/demo_debugger_soft
$ DEBUG=1 make TECHS=sim sim
```

Or program a FPGA with the hardware debugger example system

```console
$ cd systems/demo_debugger
$ DEBUG=1 make TECHS=syn program
```

To start a debug session you can either use `GDB` in terminal mode or use the
VSCode interface.

### Terminal

To attach GDB to the current running simulation type:
```console
$ ./tools/bin/pn-gdb --sim <path-to-target-app>
```

Or attach GDB to the current system running on a FPGA type:
```console
$ ./tools/bin/pn-gdb --board <path-to-target-app>
```

```{note}
The target application must be build with DEBUG=1 option to ensure debug symbols are included.
```

This attaches `GDB` to the running program. If you want to debug the program from
the first assembler command you need to restart the application. In the `GDB` console type:

```bash
b _start
j _start
```

### VSCode

Add the necessary configurations to the VSCodes configuration files.

The debugger configuration in the `launch.json`:

```json
{
    "version": "0.2.0",
    "configurations": [
        {
            "name": "(GDB) PicoNut Software Debugger",
            "type": "cppdbg",
            "request": "launch",
            "program": "${workspaceFolder}/sw/application/animation/animation.rv32",
            "args": [],
            "stopAtEntry": false,
            "cwd": "${workspaceFolder}",
            "preLaunchTask": "start-openocd-sim",
            "postDebugTask": "stop-openocd",
            "serverStarted": "Listening on port 3333",
            "environment": [],
            "externalConsole": true,
            "MIMode": "gdb",
            "miDebuggerPath": "riscv64-unknown-elf-gdb",
            "miDebuggerServerAddress": "localhost:3333",
            "setupCommands": [
                {
                    "description": "Enable pretty-printing for gdb",
                    "text": "-enable-pretty-printing",
                    "ignoreFailures": true
                },
                {
                    "description": "Set hex format for gdb",
                    "text": "set output-radix 16"
                },
                {
                    "description": "Set available registers",
                    "text": "set tdesc filename ${workspaceFolder}/tools/etc/gdb_piconut.xml"
                }
            ]
        }
    ]
}
```

The tasks to start or stop OpenOCD when a debug session is started or stopped
in the `tasks.json`:

```json
{
    "version": "2.0.0",
    "tasks": [
        {
            "label": "start-openocd-sim",
            "type": "shell",
            "command": "openocd -f ${workspaceFolder}/tools/etc/openocd-sim.cfg",
            "problemMatcher": [],
            "isBackground": true,
            "group": {
                "kind": "build",
                "isDefault": true
            },
            "presentation": {
                "echo": true,
                "reveal": "silent",
                "focus": false,
                "panel": "shared"
            }
        },
        {
            "label": "stop-openocd",
            "type": "shell",
            "command": "pkill -f openocd",
            "problemMatcher": [],
            "presentation": {
                "reveal": "never",
                "panel": "shared"
            }
        }
    ]
}
```

To start the debug session go to the `Run and Debug` menu an select the
`(GDB) PicoNut Software Debugger`. After clicking run ignore the warning popup
saying that OpenOCD hasn't terminated yet and click `Debug Anyway`.
