hsa-ees/piconut/hw/cpu/nucleus/nucleus_ref/nucleus_ref_defs.h

/*************************************************************************

  This file is part of the PicoNut project.

  Copyright (C)      2024 Lorenz Sommer <lorenz.sommer@tha.de>
                     2025 Tristan Kundrat <tristan.kundrat@tha.de>
      Technische Hochschule Augsburg, Technical University of Applied Sciences Augsburg


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
  1. Redistributions of source code must retain the above copyright notice, this
     list of conditions and the following disclaimer.

  2. Redistributions in binary form must reproduce the above copyright notice,
     this list of conditions and the following disclaimer in the documentation and/or
     other materials provided with the distribution.

  THIS SOFTWARE IS PROVIDED BY THE COPYRIGHT HOLDERS AND CONTRIBUTORS "AS IS" AND
  ANY EXPRESS OR IMPLIED WARRANTIES, INCLUDING, BUT NOT LIMITED TO, THE IMPLIED
  WARRANTIES OF MERCHANTABILITY AND FITNESS FOR A PARTICULAR PURPOSE ARE
  DISCLAIMED. IN NO EVENT SHALL THE COPYRIGHT HOLDER OR CONTRIBUTORS BE LIABLE FOR
  ANY DIRECT, INDIRECT, INCIDENTAL, SPECIAL, EXEMPLARY, OR CONSEQUENTIAL DAMAGES
  (INCLUDING, BUT NOT LIMITED TO, PROCUREMENT OF SUBSTITUTE GOODS OR SERVICES;
  LOSS OF USE, DATA, OR PROFITS; OR BUSINESS INTERRUPTION) HOWEVER CAUSED AND ON
  ANY THEORY OF LIABILITY, WHETHER IN CONTRACT, STRICT LIABILITY, OR TORT
  (INCLUDING NEGLIGENCE OR OTHERWISE) ARISING IN ANY WAY OUT OF THE USE OF THIS
  SOFTWARE, EVEN IF ADVISED OF THE POSSIBILITY OF SUCH DAMAGE.

 *************************************************************************/

/* This file is used for enumerations and other declarations to be used across multiple modules. */

#ifndef __TYPEDEF_H__
#define __TYPEDEF_H__

typedef enum
{
    ALU_MODE_IDLE = 0x0,
    ALU_MODE_REG_REG = 0x1,
    ALU_MODE_REG_IMM = 0x2,
    ALU_MODE_PASS_A = 0x3,
} e_alu_mode;

typedef enum
{
    FUNCT7_RV32I_BASE = 0x0,
    FUNCT7_RV32I_SRA_SUB = 0x20,
    FUNCT7_M_EXTENSION = 0x1,
} e_funct7;

typedef enum
{
    FUNCT3_ADD_SUB_MUL = 0x0,
    FUNCT3_SLL_MULH = 0x1,
    FUNCT3_SLT_MULHSU = 0x2,
    FUNCT3_SLTU_MULHU = 0x3,
    FUNCT3_XOR_DIV = 0x4,
    FUNCT3_SRL_SRA_DIVU = 0x5,
    FUNCT3_OR_REM = 0x6,
    FUNCT3_AND_REMU = 0x7,
} e_alu_funct3;

typedef enum
{
    FUNCT3_CSR_CSRRW = 0x1,
    FUNCT3_CSR_CSRRS = 0x2,
    FUNCT3_CSR_CSRRC = 0x3,
    FUNCT3_CSR_CSRRWI = 0x5,
    FUNCT3_CSR_CSRRSI = 0x6,
    FUNCT3_CSR_CSRRCI = 0x7,
} e_funct3_csr;

/* opcodes without bits for compressed instructions */
typedef enum
{
    OP_ALU = 0x0C,
    OP_ALUI = 0x4,
    OP_LOAD = 0x0,
    OP_STORE = 0x8,
    OP_F_LOAD = 0x1,
    OP_F_STORE = 0x9,
    OP_F_FMADD = 0x10,
    OP_F_FMSUB = 0x11,
    OP_F_FNMSUB = 0x12,
    OP_F_FNMADD = 0x13,
    OP_F_EXT = 0x14,
    OP_BRANCH = 0x18,
    OP_JAL = 0x1B,
    OP_JALR = 0x19,
    OP_LUI = 0xD,
    OP_AUIPC = 0x5,
    OP_FENCE = 0x3, // or fence.i
    OP_SYSTEM = 0x1C,
    OP_A_EXT = 0xB,
} e_opcode;

typedef enum
{
    BYTE_0 = 0x1,
    BYTE_1 = 0x2,
    BYTE_2 = 0x4,
    BYTE_3 = 0x8,
    HALF_LOWER = 0x3,
    HALF_UPPER = 0xC,
    WORD = 0xF,
} e_bsel;

typedef enum
{
    CSR_WRITE_ALL = 0x0,
    CSR_WRITE_SET = 0x1,
    CSR_WRITE_CLEAR = 0x2,
} e_csr_write_mode;

/**
 * @brief Lower 5 bits of funct7 (for crypto instructions)
 */
typedef enum
{
    FUNCT7L_AES32DSI = 0b10101,
    FUNCT7L_AES32DSMI = 0b10111,
    FUNCT7L_AES32ESI = 0b10001,
    FUNCT7L_AES32ESMI = 0b10011,
} e_funct7_lower;

typedef enum
{
    FUNCT5A_LR = 0x2,
    FUNCT5A_SC = 0x3,
    FUNCT5A_SWAP = 0x1,
    FUNCT5A_ADD = 0x0,
    FUNCT5A_AND = 0xC,
    FUNCT5A_OR = 0x8,
    FUNCT5A_XOR = 0x4,
    FUNCT5A_MAX = 0x14,
    FUNCT5A_MAXU = 0x1C,
    FUNCT5A_MIN = 0x10,
    FUNCT5A_MINU = 0x18,
} e_aext_funct5;

// TBD: apply this variable to all data signals inside the nucleus
#ifndef NUCLEUS_DATA_WIDTH
#define NUCLEUS_DATA_WIDTH 32
#endif

// TBD: find elegant way to define data width and log2 of data width
#ifndef NUCLEUS_DATA_WIDTH_LOG2
#define NUCLEUS_DATA_WIDTH_LOG2 5
#endif

/* Edit the following options inside the `piconut-config.mk` file in this
 * projects root directory or inside your system.
 */

#ifndef PN_CFG_CSR_BUS_ADR_WIDTH
#define PN_CFG_CSR_BUS_ADR_WIDTH 12U
///< @brief Width of the address in the csr bus.
#endif

#ifndef PN_CFG_CSR_BUS_DATA_WIDTH
#define PN_CFG_CSR_BUS_DATA_WIDTH 32U
///< @brief Width of the data in the csr bus.
#endif

#ifndef PN_CFG_ALU_ENABLE_M_EXTENSION
#define PN_CFG_ALU_ENABLE_M_EXTENSION 1
///< @brief enable or disable the M extension. When 1, sets Zmmul to 1 aswell.
#endif

#if PN_CFG_ALU_ENABLE_M_EXTENSION == 0

#ifndef PN_CFG_ALU_ENABLE_ZMMUL_EXTENSION
#define PN_CFG_ALU_ENABLE_ZMMUL_EXTENSION 1
#endif

#else

#define PN_CFG_ALU_ENABLE_ZMMUL_EXTENSION 1
///< @brief enable or disable the Zmmul extension
#endif

#ifndef PN_CFG_ENABLE_ZKNE_ZKND
#define PN_CFG_ENABLE_ZKNE_ZKND 1
///< @brief enable or disable the Zkne and Zknd extensions
#endif

#endif // __TYPEDEF_H__
